methylDragon/momobot/assets/colin-ni-10.jpg

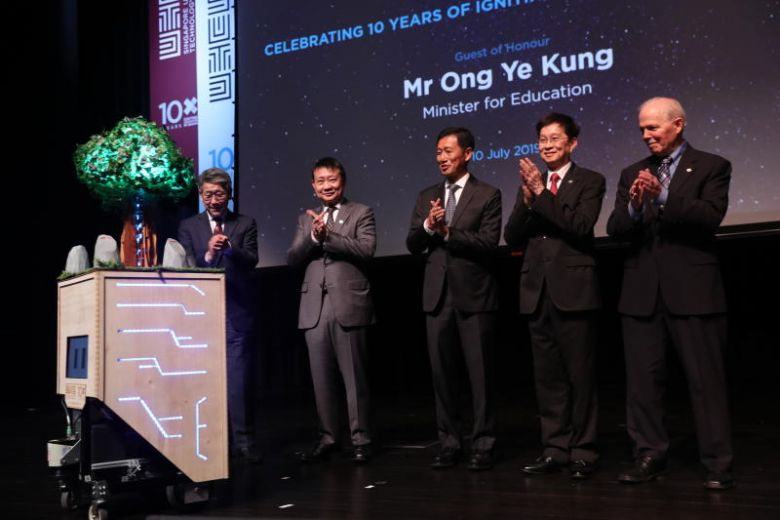
assets/colin-ni-10.jpg
