methylDragon/momobot/momobot_ws/src/momo_emotions/src/momo_1.png

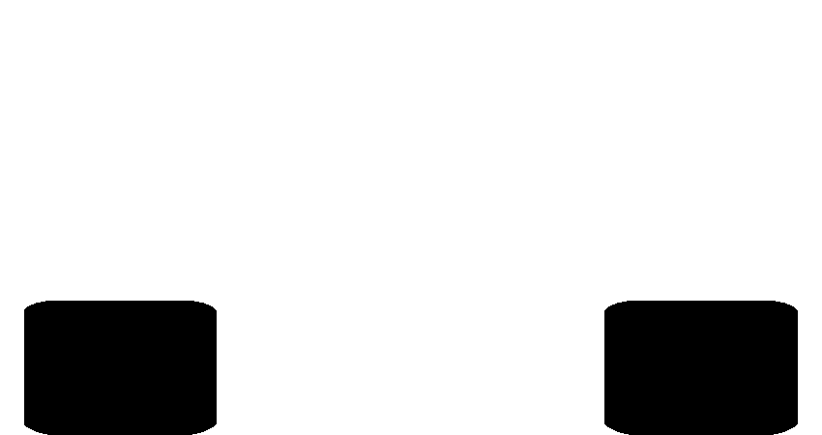
momobot_ws/src/momo_emotions/src/momo_1.png
