methylDragon/momobot/momobot_ws/src/momo_emotions/src/momo_2.png

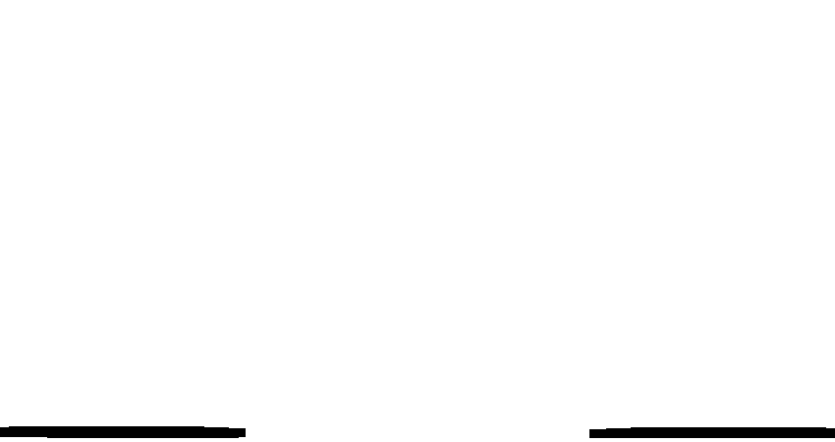
momobot_ws/src/momo_emotions/src/momo_2.png
