methylDragon/momobot/momobot_ws/src/momo_emotions/src/momo_3.png

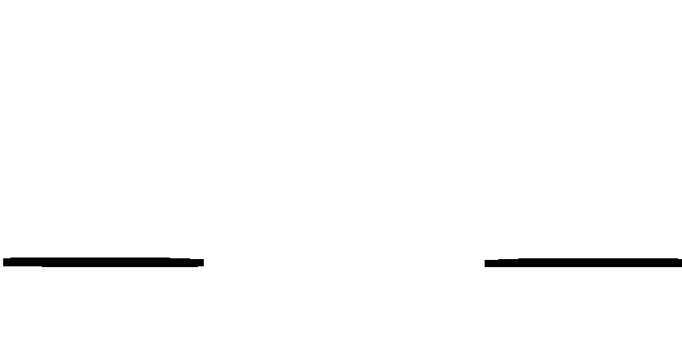
momobot_ws/src/momo_emotions/src/momo_3.png
