methylDragon/momobot/momobot_ws/src/momo_emotions/src/momo_neutral.png

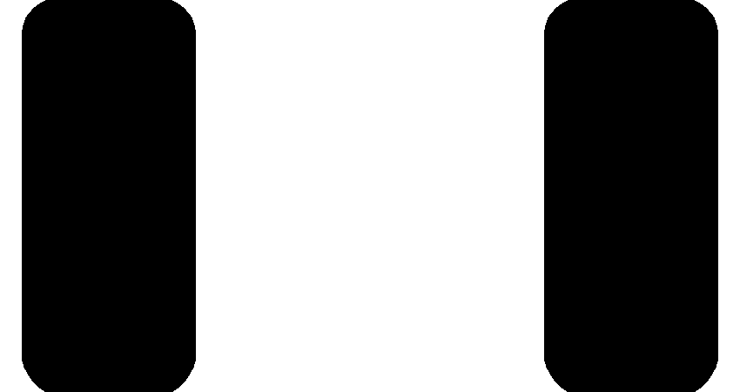
momobot_ws/src/momo_emotions/src/momo_neutral.png
