methylDragon/momobot/momobot_ws/src/momo_emotions/src/momo_XD.png

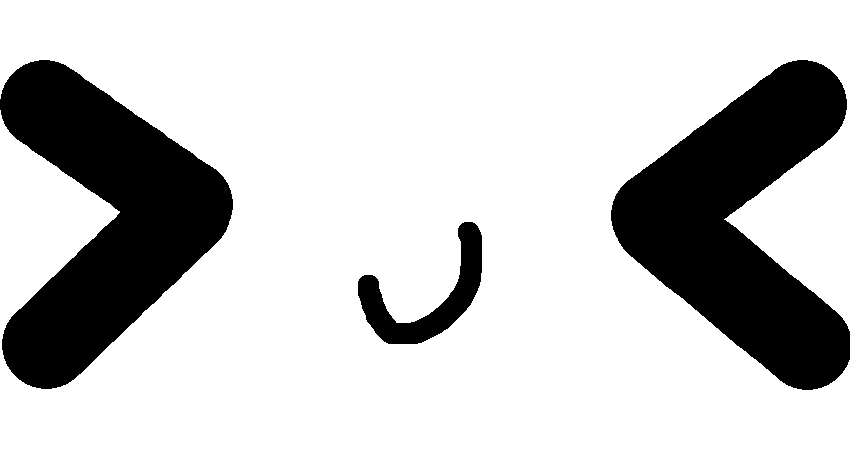
momobot_ws/src/momo_emotions/src/momo_XD.png
