methylDragon/momobot/src/LMS1xx/meshes/sick-lms1xx.stl

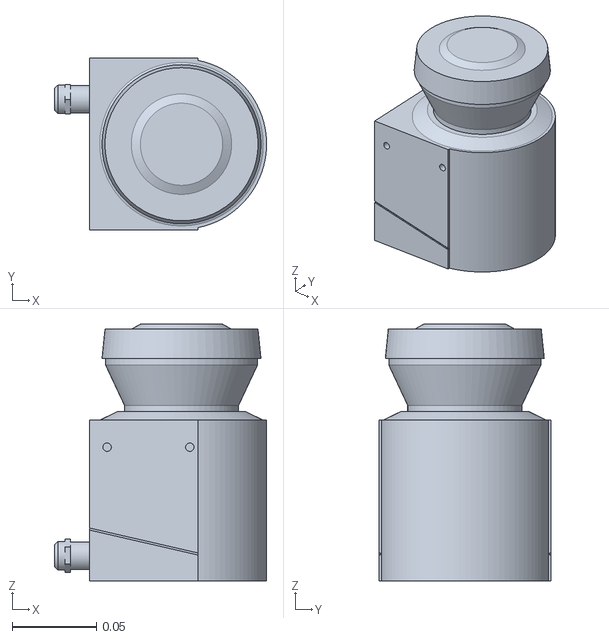
[picture p21: CAD file, 2019-04-18, last stored version]
src/LMS1xx/meshes/sick-lms1xx.stl
0.126 x 0.102 x 0.152
