methylDragon/momobot/(commit log)

2019-04-18 Add documentation
    [imu_calib.yaml, linorobot.urdf, robot_localization.yaml, sick-lms1xx.stl, sick_lms1xx.urdf.xacro]
2019-08-16 Cleanup Repo
    [imu_calib.yaml, linorobot.urdf, robot_localization.yaml, sick-lms1xx.stl, sick_lms1xx.urdf.xacro]
2019-08-16 Fix MOMO package
    [imu_calib.yaml, linorobot.urdf, robot_localization.yaml]
2019-08-16 Repackage repo as workspace
    [imu_calib.yaml, linorobot.urdf, robot_localization.yaml]
2019-08-16 Rename momobot package
    [imu_calib.yaml, linorobot.urdf, robot_localization.yaml]
